MayaPosch/BMaC/esp8266/kicad/v2.0/pwm_analogue_controller.kicad_pcb

## KiCad design esp8266/kicad/v2.0/pwm_analogue_controller.kicad_pcb (2018-02-27)

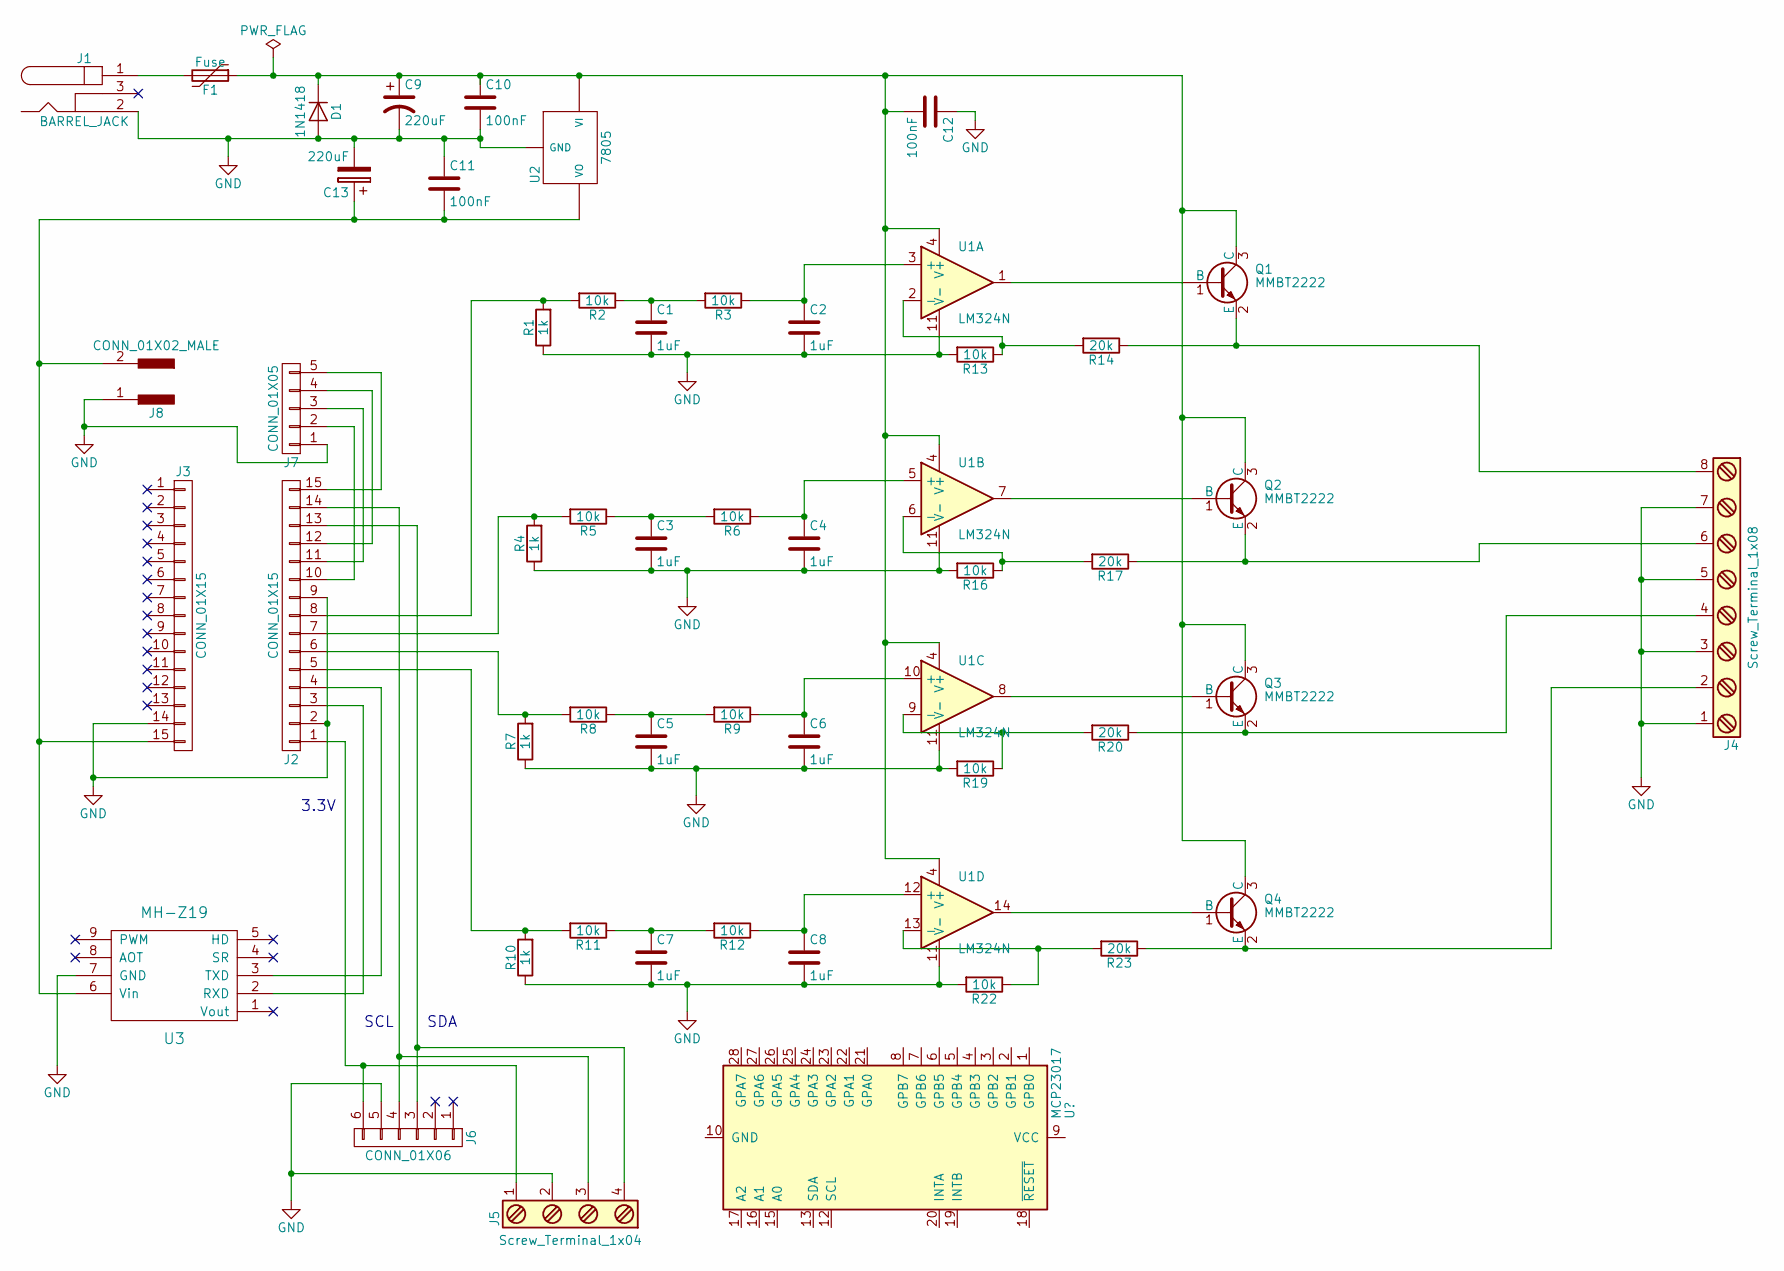
[picture p3: schematic pwm_analogue_controller.sch, ESP8266 AC controller]

Parts:
C1, C2, C3, C4, C5, C6, C7, C8: 1uF; C_0805_HandSoldering
C9, C13: 220uF; CP_Elec_10x10
C10, C11, C12: 100nF; C_0805_HandSoldering
D1: 1N1418; D_SOD-123
F1: Fuse; Fuse_SMD1206_HandSoldering
J1: BARREL_JACK; Pin_Header_Straight_1x02_Pitch2.54mm
J2, J3: CONN_01X15; Socket_Strip_Straight_1x15_Pitch2.54mm
J4: Screw_Terminal_1x08; TerminalBlock_Pheonix_MPT-2.54mm_8pol
J5: Screw_Terminal_1x04; TerminalBlock_Pheonix_MPT-2.54mm_4pol
J6: CONN_01X06; Socket_Strip_Straight_1x06_Pitch2.54mm
J7: CONN_01X05; Pin_Header_Straight_1x05_Pitch2.54mm
J8: CONN_01X02_MALE; Pin_Header_Straight_1x02_Pitch2.54mm
Q1, Q2, Q3, Q4: MMBT2222; SOT-23_Handsoldering
R1, R4, R7, R10: 1k; R_0805_HandSoldering
R2, R3, R5, R6, R8, R9, R11, R12, R13, R16, R19, R22: 10k; R_0805_HandSoldering
R14, R17, R20, R23: 20k; R_0805_HandSoldering
U1: LM324N; SOIC-14_3.9x8.7mm_Pitch1.27mm
U2: 7805; DCDC-Conv_RECOM_R-78E-0.5
U3: MH-Z19

Connections:
GND: C1.2, C2.2, C3.2, C4.2, C5.2, C6.2, C7.2, C8.2, C9.2, C10.2, C11.1, C12.1, C13.2, D1.2 (A), J1.2, J2.2, J2.9, J3.14, J4.1, J4.3, J4.5, J4.7, J5.2, J6.5, J7.1, J8.1, R1.1, R4.1, R7.1, R10.1, R13.2, R16.2, R19.2, R22.2, U1.11 (V-), U2.2 (GND), U3.7 (GND); also elsewhere on the board
unnamed: C1.1, R2.1, R3.2
unnamed: C2.1, R3.1, U1.3 (+)
unnamed: C3.1, R5.1, R6.2
unnamed: C4.1, R6.1, U1.5 (+)
unnamed: C5.1, R8.1, R9.2
unnamed: C6.1, R9.1, U1.10 (+)
unnamed: C7.1, R11.1, R12.2
unnamed: C8.1, R12.1, U1.12 (+)
unnamed 9: C9.1, C10.1, C12.2, D1.1 (K), F1.1, Q1.3 (C), Q2.3 (C), Q3.3 (C), Q4.3 (C), U1.4 (V+), U2.1 (VI); also elsewhere on the board
unnamed: C11.2, C13.1, J3.15, J8.2, U2.3 (VO), U3.6 (Vin)
unnamed: F1.2, J1.1
unnamed: J2.1, J5.1, J6.6
unnamed: J2.3, U3.2 (RXD)
unnamed: J2.4, U3.3 (TXD)
unnamed: J2.5, R10.2, R11.2
unnamed: J2.6, R7.2, R8.2
unnamed: J2.7, R4.2, R5.2
unnamed: J2.8, R1.2, R2.2
unnamed: J2.10, J7.2
unnamed: J2.11, J7.3
unnamed: J2.12, J7.4
unnamed: J2.13, J5.4, J6.3
unnamed: J2.14, J5.3, J6.4
unnamed: J2.15, J7.5
unnamed: J4.2, Q4.2 (E), R23.1
unnamed: J4.4, Q3.2 (E), R20.1
unnamed: J4.6, Q2.2 (E), R17.1
unnamed: J4.8, Q1.2 (E), R14.1
unnamed: Q1.1 (B), U1.1
unnamed: Q2.1 (B), U1.7
unnamed: Q3.1 (B), U1.8
unnamed: Q4.1 (B), U1.14
unnamed: R13.1, R14.2, U1.2 (-)
unnamed: R16.1, R17.2, U1.6 (-)
unnamed: R19.1, R20.2, U1.9 (-)
unnamed: R22.1, R23.2, U1.13 (-)

Notes on the sheet:
3.3V
SCL
SDA

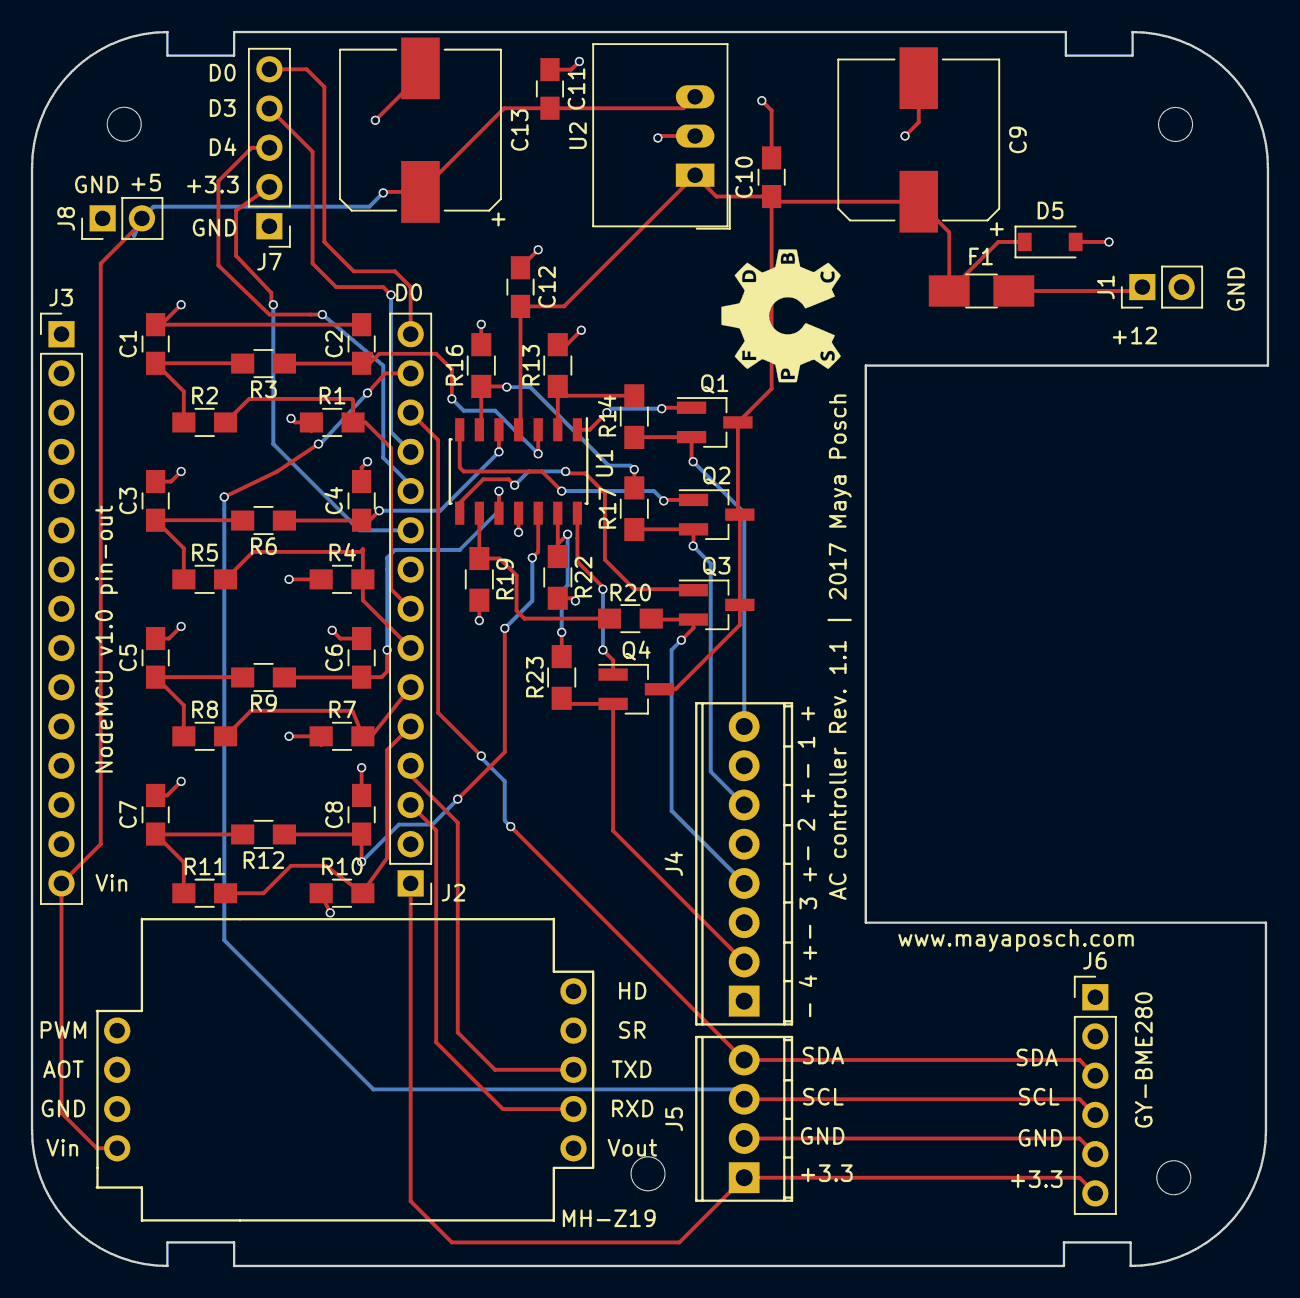
[picture p4: board pwm_analogue_controller.kicad_pcb from above]

Board: 2 copper layers, 80.0 x 79.9 mm, 50 parts (0 on the bottom side), 37 nets.

Other parts of the board:
D5: D; D_SOD-123

Their connections:
GND: D5.2; also elsewhere on the board
unnamed 9: D5.1; also elsewhere on the board
