MayaPosch/BMaC/esp8266/app/bme280_module.h

/*
	bme280_module.h - Header for the BME280 module class.
	
	Revision 0
	
	Features:
			- Declares the basic class needed for ESP8266 BME280 functionality.
			
	2017/05/10, Maya Posch
*/


#ifndef BME280_MODULE_H
#define BME280_MODULE_H


#include "ota_core.h"

#include <Libraries/BME280/BME280.h>


class BME280Module {
	static BME280* bme280;
	static Timer timer;
	
public:
	static bool init();
	static bool shutdown();
	static void config(String cmd);
	static void readSensor();
};


#endif
