MayaPosch/BMaC/test/node/SmingCore/Network/libmosquitto/util_mosq.c

/*
Copyright (c) 2009-2018 Roger Light <roger@atchoo.org>

All rights reserved. This program and the accompanying materials
are made available under the terms of the Eclipse Public License v1.0
and Eclipse Distribution License v1.0 which accompany this distribution.

The Eclipse Public License is available at
   http://www.eclipse.org/legal/epl-v10.html
and the Eclipse Distribution License is available at
  http://www.eclipse.org/org/documents/edl-v10.php.

Contributors:
   Roger Light - initial implementation and documentation.
*/

#include "config.h"

#include <assert.h>
#include <string.h>

#ifdef WIN32
#  include <winsock2.h>
#  include <aclapi.h>
#  include <io.h>
#  include <lmcons.h>
#else
#  include <sys/stat.h>
#endif


#ifdef WITH_BROKER
#include "mosquitto_broker_internal.h"
#endif

#include "mosquitto.h"
#include "memory_mosq.h"
#include "net_mosq.h"
#include "send_mosq.h"
#include "time_mosq.h"
#include "tls_mosq.h"
#include "util_mosq.h"

#ifdef WITH_WEBSOCKETS
#include <libwebsockets.h>
#endif

#ifdef WITH_BROKER
void mosquitto__check_keepalive(struct mosquitto_db *db, struct mosquitto *mosq)
#else
void mosquitto__check_keepalive(struct mosquitto *mosq)
#endif
{
	time_t next_msg_out;
	time_t last_msg_in;
	time_t now = mosquitto_time();
#ifndef WITH_BROKER
	int rc;
#endif

	assert(mosq);
#if defined(WITH_BROKER) && defined(WITH_BRIDGE)
	/* Check if a lazy bridge should be timed out due to idle. */
	if(mosq->bridge && mosq->bridge->start_type == bst_lazy
				&& mosq->sock != INVALID_SOCKET
				&& now - mosq->next_msg_out - mosq->keepalive >= mosq->bridge->idle_timeout){

		log__printf(NULL, MOSQ_LOG_NOTICE, "Bridge connection %s has exceeded idle timeout, disconnecting.", mosq->id);
		net__socket_close(db, mosq);
		return;
	}
#endif
	pthread_mutex_lock(&mosq->msgtime_mutex);
	next_msg_out = mosq->next_msg_out;
	last_msg_in = mosq->last_msg_in;
	pthread_mutex_unlock(&mosq->msgtime_mutex);
	if(mosq->keepalive && mosq->sock != INVALID_SOCKET &&
			(now >= next_msg_out || now - last_msg_in >= mosq->keepalive)){

		if(mosq->state == mosq_cs_connected && mosq->ping_t == 0){
			send__pingreq(mosq);
			/* Reset last msg times to give the server time to send a pingresp */
			pthread_mutex_lock(&mosq->msgtime_mutex);
			mosq->last_msg_in = now;
			mosq->next_msg_out = now + mosq->keepalive;
			pthread_mutex_unlock(&mosq->msgtime_mutex);
		}else{
#ifdef WITH_BROKER
			if(mosq->listener){
				mosq->listener->client_count--;
				assert(mosq->listener->client_count >= 0);
			}
			mosq->listener = NULL;
			net__socket_close(db, mosq);
#else
			net__socket_close(mosq);
			pthread_mutex_lock(&mosq->state_mutex);
			if(mosq->state == mosq_cs_disconnecting){
				rc = MOSQ_ERR_SUCCESS;
			}else{
				rc = MOSQ_ERR_KEEPALIVE;
			}
			pthread_mutex_unlock(&mosq->state_mutex);
			pthread_mutex_lock(&mosq->callback_mutex);
			if(mosq->on_disconnect){
				mosq->in_callback = true;
				mosq->on_disconnect(mosq, mosq->userdata, rc);
				mosq->in_callback = false;
			}
			pthread_mutex_unlock(&mosq->callback_mutex);
#endif
		}
	}
}

uint16_t mosquitto__mid_generate(struct mosquitto *mosq)
{
	/* FIXME - this would be better with atomic increment, but this is safer
	 * for now for a bug fix release.
	 *
	 * If this is changed to use atomic increment, callers of this function
	 * will have to be aware that they may receive a 0 result, which may not be
	 * used as a mid.
	 */
	uint16_t mid;
	assert(mosq);

	pthread_mutex_lock(&mosq->mid_mutex);
	mosq->last_mid++;
	if(mosq->last_mid == 0) mosq->last_mid++;
	mid = mosq->last_mid;
	pthread_mutex_unlock(&mosq->mid_mutex);

	return mid;
}

/* Check that a topic used for publishing is valid.
 * Search for + or # in a topic. Return MOSQ_ERR_INVAL if found.
 * Also returns MOSQ_ERR_INVAL if the topic string is too long.
 * Returns MOSQ_ERR_SUCCESS if everything is fine.
 */
int mosquitto_pub_topic_check(const char *str)
{
	int len = 0;
	while(str && str[0]){
		if(str[0] == '+' || str[0] == '#'){
			return MOSQ_ERR_INVAL;
		}
		len++;
		str = &str[1];
	}
	if(len > 65535) return MOSQ_ERR_INVAL;

	return MOSQ_ERR_SUCCESS;
}

int mosquitto_pub_topic_check2(const char *str, size_t len)
{
	int i;

	if(len > 65535) return MOSQ_ERR_INVAL;

	for(i=0; i<len; i++){
		if(str[i] == '+' || str[i] == '#'){
			return MOSQ_ERR_INVAL;
		}
	}

	return MOSQ_ERR_SUCCESS;
}

/* Check that a topic used for subscriptions is valid.
 * Search for + or # in a topic, check they aren't in invalid positions such as
 * foo/#/bar, foo/+bar or foo/bar#.
 * Return MOSQ_ERR_INVAL if invalid position found.
 * Also returns MOSQ_ERR_INVAL if the topic string is too long.
 * Returns MOSQ_ERR_SUCCESS if everything is fine.
 */
int mosquitto_sub_topic_check(const char *str)
{
	char c = '\0';
	int len = 0;
	while(str && str[0]){
		if(str[0] == '+'){
			if((c != '\0' && c != '/') || (str[1] != '\0' && str[1] != '/')){
				return MOSQ_ERR_INVAL;
			}
		}else if(str[0] == '#'){
			if((c != '\0' && c != '/')  || str[1] != '\0'){
				return MOSQ_ERR_INVAL;
			}
		}
		len++;
		c = str[0];
		str = &str[1];
	}
	if(len > 65535) return MOSQ_ERR_INVAL;

	return MOSQ_ERR_SUCCESS;
}

int mosquitto_sub_topic_check2(const char *str, size_t len)
{
	char c = '\0';
	int i;

	if(len > 65535) return MOSQ_ERR_INVAL;

	for(i=0; i<len; i++){
		if(str[i] == '+'){
			if((c != '\0' && c != '/') || (i<len-1 && str[i+1] != '/')){
				return MOSQ_ERR_INVAL;
			}
		}else if(str[i] == '#'){
			if((c != '\0' && c != '/')  || i<len-1){
				return MOSQ_ERR_INVAL;
			}
		}
		c = str[i];
	}

	return MOSQ_ERR_SUCCESS;
}

int mosquitto_topic_matches_sub(const char *sub, const char *topic, bool *result)
{
	int slen, tlen;

	if(!result) return MOSQ_ERR_INVAL;
	*result = false;

	if(!sub || !topic){
		return MOSQ_ERR_INVAL;
	}

	slen = strlen(sub);
	tlen = strlen(topic);

	return mosquitto_topic_matches_sub2(sub, slen, topic, tlen, result);
}
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
