MayaPosch/BMaC/(commit log)

2017-12-27 Fix sending of mimetype in the HTTP datahandler.
    [datahandler.h]
2017-12-28 [OTA] Fix behaviour of dialogues when using the default buttons to close the dialogue.
    [firmwaredialogue.cpp, firmwaredialogue.h, httprequestfactory.h, mainwindow.cpp, nodefirmwaredialogue.cpp, nodefirmwaredialogue.h]
2018-02-27 Added AC controller KiCad project files.
    [pwm_analogue_controller.kicad_pcb, pwm_analogue_controller.sch]
2018-09-17 Refactored firmware, added plant module.
    [pwm_analogue_controller.kicad_pcb, pwm_analogue_controller.sch]
2018-11-21 Finish SPI, I2C code skeletons in ESP mockup.
2018-11-26 Finished all but the Node & Device classes.
2018-11-27 Finish I2C and UART links in Node class.
2018-12-04 Add missing functions & reimplementations.
    [SmingCore.h]
2018-12-04 Set up skeleton for device/room connection.
2018-12-05 Finalise I2C interface mock.
2018-12-06 Finish I2C interface with hardcoded BME280 sensor implementation.
2018-12-09 Finish UART implementation in sim server. Validate code compiles.
2018-12-11 Finalise all but Wiring classes.
2018-12-13 Add BME280 sensor library to testing framework.
2019-02-06 Update client to work with current Libmosquitto version on Windows.
2019-03-23 Update integration test for current Sming develop branch. Fix NymphRPC issue in server.
2019-03-24 [TEST] Fix various small issues with test server.
    [SmingCore.cpp, device.cpp, device.h, floor.cpp, node.cpp, room.cpp, room.h, simulation.cpp]
2019-03-25 [TEST] Fix range of data handling issues.
    [building.cpp, floor.cpp, node.cpp, nodes.cpp, nodes.h, room.cpp, simulation.cpp]
2019-03-25 [TEST] Fix string split utility function in server.
    [utility.cpp]
2019-04-06 Update project for current development version of Sming.
2019-04-06 Update HX711 library, fix existing HX711 library.
    [plant_module.cpp]
2021-01-07 Update build system for current Sming version.
2021-01-07 Update application code for current Sming version.
2022-09-01 Fix DataHandler merge issues.
    [datahandler.h, nodes.cpp]
2022-09-01 Fix Nodes JSON & other small issues.
    [nodes.cpp]
2022-09-01 Filter out null rows from nodes database.
2022-09-01 Fix JSON conversion, payload size, JSON parsing UI.
    [mqtt_listener.cpp, nodes.cpp]
2022-09-01 Fix reading out of node update JSON.
    [cchandler.h]
2022-09-02 Fix node table insertion query. Fix update response.
    [cchandler.h, nodes.cpp]
2022-09-02 Fix row insert location & row removal.
2022-09-05 Get SPIFFS slot from OtaManager
2022-09-05 Redirect Host debug output from UART1 to console
2022-09-05 Fix reading out WiFi credentials file.
    [ota_core.cpp]
2022-09-15 Fix adding of monitoring topics.
    [controller.cpp, influx_client.cpp, mqtt_listener.cpp]
2022-09-18 Fixes after NyanSD integration.
    [nyansd_client.cpp, ota_core.cpp]
2022-12-03 Fix cast overview with unsigned type.
    [mqtt_listener.cpp]
